jairrama09-L/Lab2-V20-ESP32/docs/esquematico/esquematico_v20_iot.png

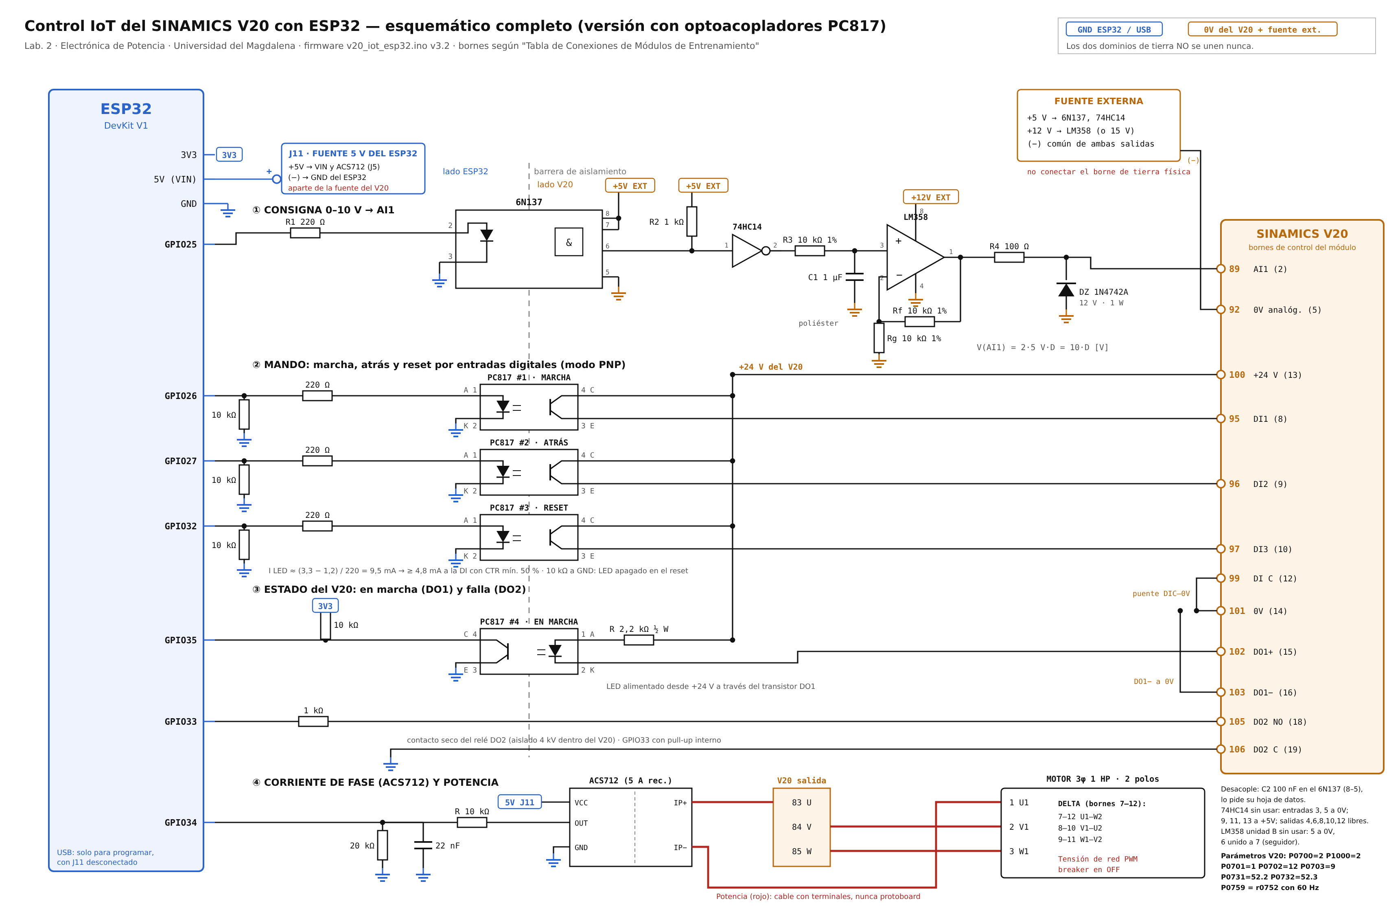
docs/esquematico/esquematico_v20_iot.png
