jairrama09-L/Lab2-V20-ESP32/docs/figuras/fig_escalon.png

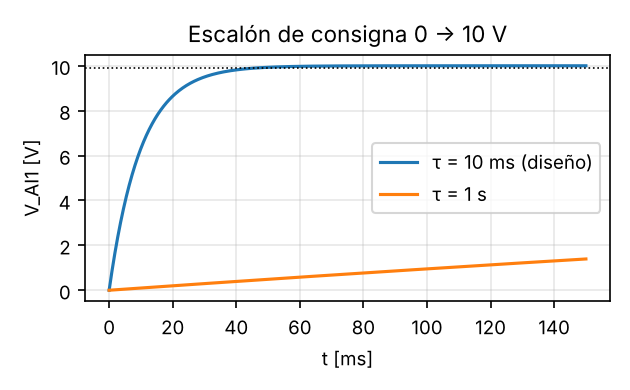
docs/figuras/fig_escalon.png
