jairrama09-L/Lab2-V20-ESP32/docs/figuras/fig_rizado_D05.png

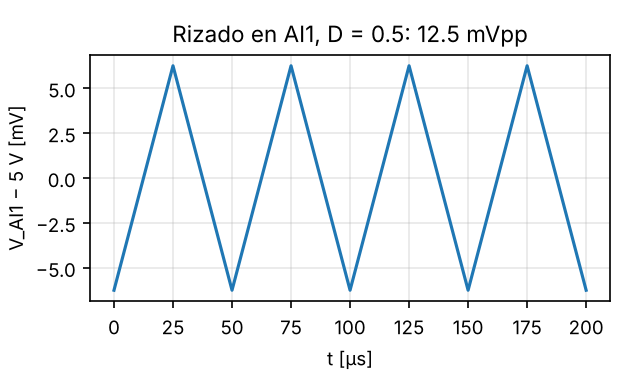
docs/figuras/fig_rizado_D05.png
