jairrama09-L/Lab2-V20-ESP32/docs/figuras/fig_rizado_vs_D.png

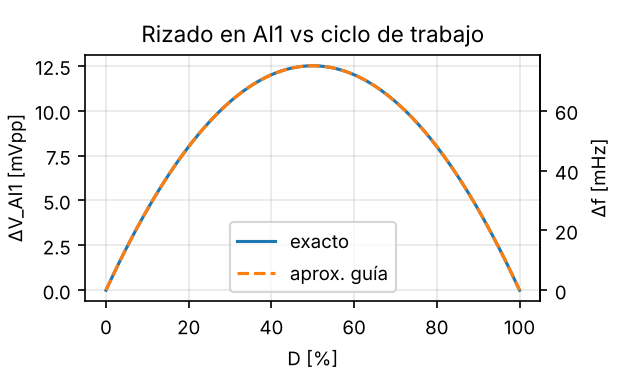
docs/figuras/fig_rizado_vs_D.png
