jairrama09-L/Lab2-V20-ESP32/docs/figuras/fig_vf_teoricas.png

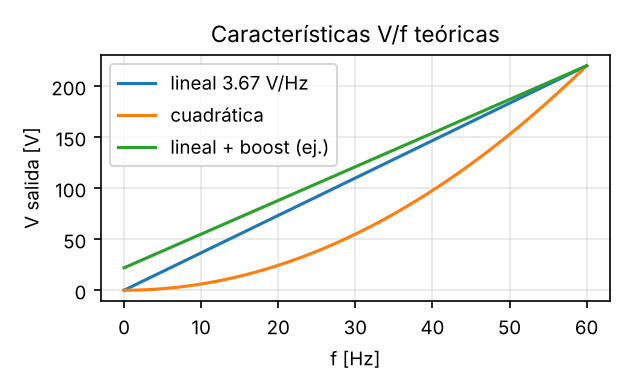
docs/figuras/fig_vf_teoricas.png
