jairrama09-L/Lab2-V20-ESP32/pcb/salida/netlist_V20IoT.csv

Referencia | Valor | Pin | Net
J1 | ESP32 lado A | 1 | V5E
J1 | ESP32 lado A | 2 | GND
J1 | ESP32 lado A | 6 | G27
J1 | ESP32 lado A | 7 | G26
J1 | ESP32 lado A | 8 | G25
J1 | ESP32 lado A | 9 | G33
J1 | ESP32 lado A | 10 | G32
J1 | ESP32 lado A | 11 | G35
J1 | ESP32 lado A | 12 | G34
J2 | ESP32 lado B (22,86) | 1 | V33
J3 | ESP32 lado B (25,40) | 1 | V33
OK2 | PC817 | 1 | A_OK2
OK2 | PC817 | 2 | GND
OK2 | PC817 | 3 | DI2
OK2 | PC817 | 4 | V24
OK1 | PC817 | 1 | A_OK1
OK1 | PC817 | 2 | GND
OK1 | PC817 | 3 | DI1
OK1 | PC817 | 4 | V24
U1 | 6N137 | 2 | A6
U1 | 6N137 | 3 | GND
U1 | 6N137 | 5 | GX
U1 | 6N137 | 6 | VO6
U1 | 6N137 | 7 | P5X
U1 | 6N137 | 8 | P5X
OK3 | PC817 | 1 | A_OK3
OK3 | PC817 | 2 | GND
OK3 | PC817 | 3 | DI3
OK3 | PC817 | 4 | V24
OK4 | PC817 | 1 | A_OK4
OK4 | PC817 | 2 | DO1P
OK4 | PC817 | 3 | GND
OK4 | PC817 | 4 | G35
R5 | 220 | 1 | G27
R5 | 220 | 2 | A_OK2
R8 | 10k | 1 | G27
R8 | 10k | 2 | GND
R6 | 220 | 1 | G26
R6 | 220 | 2 | A_OK1
R9 | 10k | 1 | G26
R9 | 10k | 2 | GND
R1 | 220 | 1 | G25
R1 | 220 | 2 | A6
R7 | 220 | 1 | G32
R7 | 220 | 2 | A_OK3
R10 | 10k | 1 | G32
R10 | 10k | 2 | GND
R11 | 10k | 1 | V33
R11 | 10k | 2 | G35
R12 | 1k | 1 | DO2NO
R12 | 1k | 2 | G33
R13 | 10k | 1 | ACSO
R13 | 10k | 2 | G34
R14 | 20k | 1 | G34
R14 | 20k | 2 | GND
C5 | 22n | 1 | G34
C5 | 22n | 2 | GND
J5 | ACS712 | 1 | V5E
J5 | ACS712 | 2 | ACSO
J5 | ACS712 | 3 | GND
J6 | DO2 | 1 | DO2NO
J6 | DO2 | 2 | GND
J11 | 5V ESP32 | 1 | V5E
J11 | 5V ESP32 | 2 | GND
R2 | 1k | 1 | P5X
R2 | 1k | 2 | VO6
C2 | 100n | 1 | P5X
C2 | 100n | 2 | GX
U2 | 74HC14 | 1 | VO6
U2 | 74HC14 | 2 | HCO
U2 | 74HC14 | 3 | GX
U2 | 74HC14 | 5 | GX
U2 | 74HC14 | 7 | GX
U2 | 74HC14 | 9 | P5X
U2 | 74HC14 | 11 | P5X
U2 | 74HC14 | 13 | P5X
U2 | 74HC14 | 14 | P5X
R3 | 10k | 1 | HCO
R3 | 10k | 2 | RCN
C1 | 1u | 1 | RCN
C1 | 1u | 2 | GX
U3 | LM358 | 1 | OPO
U3 | LM358 | 2 | FB
U3 | LM358 | 3 | RCN
U3 | LM358 | 4 | GX
U3 | LM358 | 5 | GX
U3 | LM358 | 6 | LMB
U3 | LM358 | 7 | LMB
U3 | LM358 | 8 | P12X
R15 | 10k | 1 | FB
R15 | 10k | 2 | GX
R16 | 10k | 1 | OPO
R16 | 10k | 2 | FB
R4 | 100 | 1 | OPO
R4 | 100 | 2 | AI1
D1 | 1N4742A | 1 | AI1
D1 | 1N4742A | 2 | GX
J7 | ALIM | 1 | P5X
J7 | ALIM | 2 | P12X
J7 | ALIM | 3 | GX
J8 | AI1 | 1 | AI1
J8 | AI1 | 2 | GX
J9 | DI | 1 | V24
J9 | DI | 2 | DI2
J9 | DI | 3 | DI1
J10 | DI/DO | 1 | DI3
J10 | DI/DO | 2 | DO1P
R17 | 2,2k | 1 | A_OK4
R17 | 2,2k | 2 | V24
