jairrama09-L/Lab2-V20-ESP32/calculos/resultados.txt

======================================================================
1. FILTRO RC
======================================================================
tau = RC            = 10.0 ms
fc = 1/(2 pi RC)    = 15.92 Hz
|H(20 kHz)|         = 7.958e-04  (-62.0 dB)
ts (5 tau)          = 50 ms ;  ts al 1 % (4.6 tau) = 46 ms

======================================================================
2. RIZADO (aprox. lineal de la guía vs. solución exponencial exacta)
======================================================================
D=0.10: filtro  2.250 mVpp (aprox) |  2.250 mVpp (exacto) -> AI1   4.50 mVpp =  27.0 mHz
D=0.25: filtro  4.688 mVpp (aprox) |  4.687 mVpp (exacto) -> AI1   9.37 mVpp =  56.2 mHz
D=0.50: filtro  6.250 mVpp (aprox) |  6.250 mVpp (exacto) -> AI1  12.50 mVpp =  75.0 mHz
D=0.75: filtro  4.688 mVpp (aprox) |  4.687 mVpp (exacto) -> AI1   9.37 mVpp =  56.2 mHz
D=0.90: filtro  2.250 mVpp (aprox) |  2.250 mVpp (exacto) -> AI1   4.50 mVpp =  27.0 mHz

======================================================================
3. RESOLUCIÓN
======================================================================
 8 bits: dV =  39.22 mV -> df = 0.2353 Hz
10 bits: dV =   9.78 mV -> df = 0.0587 Hz
12 bits: dV =   2.44 mV -> df = 0.0147 Hz
ADC del V20 = 10 bits (manual). Si cubre 0..10 V: 9.8 mV (0.059 Hz);
si su rango interno es +/-10 V: 19.6 mV (0.117 Hz) -> el ADC limitaría, no el PWM.

======================================================================
4. ENTRADA 6N137 (LED) desde GPIO 3.3 V con 220 ohm
======================================================================
V_GPIO=3.30 V, VF=1.38 V -> IF =  8.73 mA OK (>5 mA umbral max)
V_GPIO=3.30 V, VF=1.70 V -> IF =  7.27 mA OK (>5 mA umbral max)
V_GPIO=3.00 V, VF=1.38 V -> IF =  7.36 mA OK (>5 mA umbral max)
V_GPIO=3.00 V, VF=1.70 V -> IF =  5.91 mA OK (>5 mA umbral max)
V_GPIO=2.64 V, VF=1.38 V -> IF =  5.73 mA OK (>5 mA umbral max)
V_GPIO=2.64 V, VF=1.70 V -> IF =  4.27 mA MARGEN BAJO

======================================================================
5. SALIDA 6N137 con pull-up 1 kohm a 5 V
======================================================================
I_OL = (5-0.4)/1k = 4.6 mA  (máx. prueba 13 mA; RL rec. 330..4k) OK
tau_subida ~ 1k*25pF = 25 ns << T = 50 us
Distorsión de ancho  10 ns -> error de D = 0.020 % -> 12 mHz
Distorsión de ancho  40 ns -> error de D = 0.080 % -> 48 mHz
Distorsión de ancho  90 ns -> error de D = 0.180 % -> 108 mHz

======================================================================
6. TOLERANCIAS -> FONDO DE ESCALA (D=100 %)
======================================================================
Ganancia con R 1 %: 1.9802 .. 2.0202
V_FS: 9.41 V .. 10.61 V
Sin calibrar P0759 (=10 V): f_max = 56.4 .. 63.6 Hz (error -5.9 % .. +6.1 %)
Ejemplo de la guía: r0752=9.62 V -> 57.7 Hz (-3.8 %)
Ojo: si V_FS > 10 V la consigna de 60 Hz se alcanza antes de D=100 % (o AI1 satura).
Offset LM358 (2 mV typ, 7 mV max) x2 -> 24..84 mHz
Carga AI1 (>30 kohm) con 100 ohm serie -> error <= 0.33 % (lo absorbe P0759, r0752 mide en el borne)
Precisión del ADC del V20: +/-5 % de fondo de escala (manual) -> por eso se calibra con r0752.

======================================================================
7. PROTECCIÓN ZENER 1N4742A (12 V +/-5 %) tras 100 ohm
======================================================================
Vz=11.4 V: Iz =  21.0 mA, Pz =   239 mW (1 W) ; LM358 Isc ~40 mA OK
Vz=12.0 V: Iz =  15.0 mA, Pz =   180 mW (1 W) ; LM358 Isc ~40 mA OK
Vz=12.6 V: Iz =   9.0 mA, Pz =   113 mW (1 W) ; LM358 Isc ~40 mA OK
Fuga IR ~5 uA @ 9.1 V -> caída en 100 ohm = 0.5 mV (despreciable)

======================================================================
8. ALIMENTACIÓN DESDE 24 V DEL V20 (-15 %/+20 % -> 20.4..28.8 V; máx 50 mA)
======================================================================
  6N137 ICC                    10.00 mA
  pull-up 1k (prom D=0.5)       2.30 mA
  74HC14                        0.50 mA
  LM358 Icc                     1.20 mA
  realim. 20k a 10 V            0.50 mA
  AI1 (30k)                     0.33 mA
  TOTAL ~ 14.8 mA  (30 % de 50 mA)
  Vin=20.4 V: P_78L15 =   80 mW ; P_78L05 =  128 mW (TO-92 ~600 mW)
  Vin=24.0 V: P_78L15 =  133 mW ; P_78L05 =  128 mW (TO-92 ~600 mW)
  Vin=28.8 V: P_78L15 =  205 mW ; P_78L05 =  128 mW (TO-92 ~600 mW)
  Dropout 78L15 ~1.7 V -> requiere Vin >= 16.7 V; mínimo garantizado 20.4 V OK

======================================================================
9. MOTOR Y V/f
======================================================================
Motor 2 polos: ns(60 Hz) = 3600 rpm ; pendiente V/f = 220/60 = 3.667 V/Hz
  10 Hz: V_lineal =   36.7 V ; V_cuad (sin boost) =    6.1 V ; ns =   600 rpm
  20 Hz: V_lineal =   73.3 V ; V_cuad (sin boost) =   24.4 V ; ns =  1200 rpm
  30 Hz: V_lineal =  110.0 V ; V_cuad (sin boost) =   55.0 V ; ns =  1800 rpm
  40 Hz: V_lineal =  146.7 V ; V_cuad (sin boost) =   97.8 V ; ns =  2400 rpm
  50 Hz: V_lineal =  183.3 V ; V_cuad (sin boost) =  152.8 V ; ns =  3000 rpm
  60 Hz: V_lineal =  220.0 V ; V_cuad (sin boost) =  220.0 V ; ns =  3600 rpm
Rampa: P1120 se mide de 0 a P1082 -> hacer la Tabla 2 con P1082 = 60 Hz
  P1120= 5 s: dw/dt =   75.4 rad/s^2 -> T_acel = J*75.4
  P1120=10 s: dw/dt =   37.7 rad/s^2 -> T_acel = J*37.7
  P1120=20 s: dw/dt =   18.8 rad/s^2 -> T_acel = J*18.8

Figuras guardadas en /home/claude/lab2/figuras
