jairrama09-L/Lab2-V20-ESP32/sim/resultados/app_03_marcha_atras.png

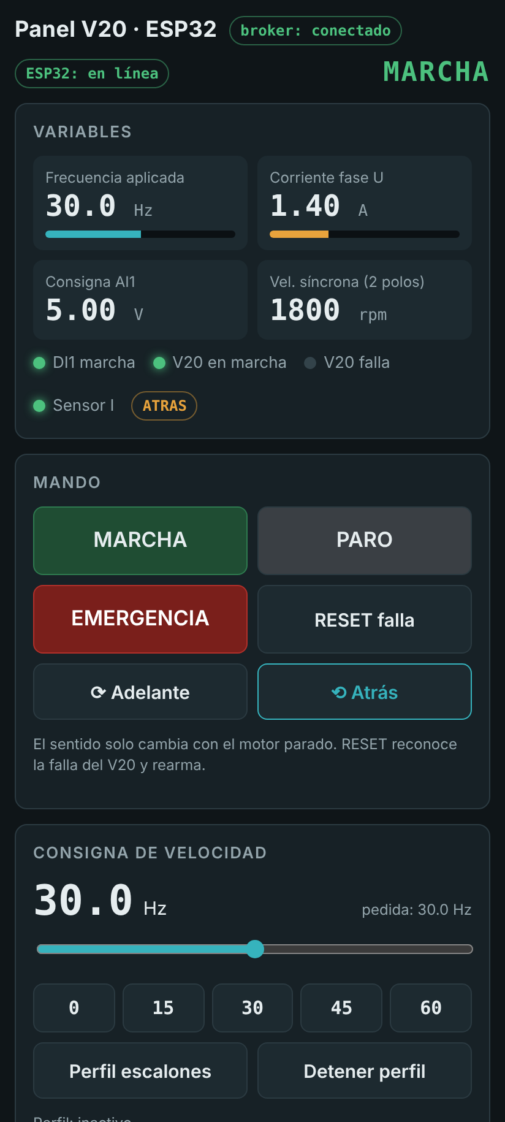
sim/resultados/app_03_marcha_atras.png
