jairrama09-L/Lab2-V20-ESP32/sim/resultados/app_06_final.png

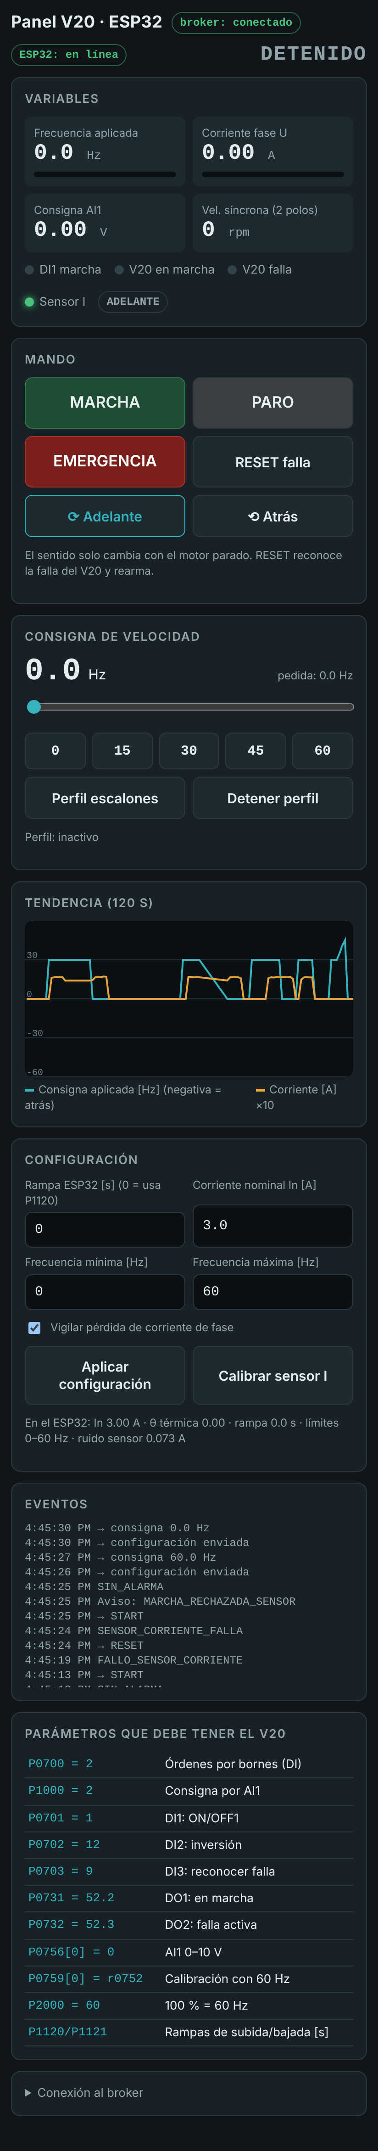
sim/resultados/app_06_final.png
