jairrama09-L/Lab2-V20-ESP32/(commit log)

2026-10-20 Add files via upload
    Lab 2 completo
    [planta.csv, telemetria.csv]
2026-10-24 Firmware v3.2 con PC817, esquemático, PCB e informe
    [datos_lab2.csv, netlist_V20IoT.csv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]
